sabeshraaj/E-Mesh32/Results/Fig3.jpeg

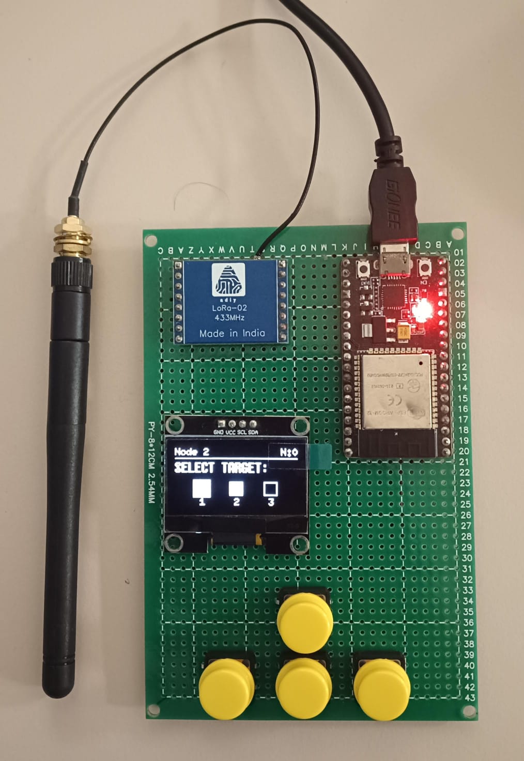
Results/Fig3.jpeg
