sabeshraaj/E-Mesh32/Results/Fig4.jpeg

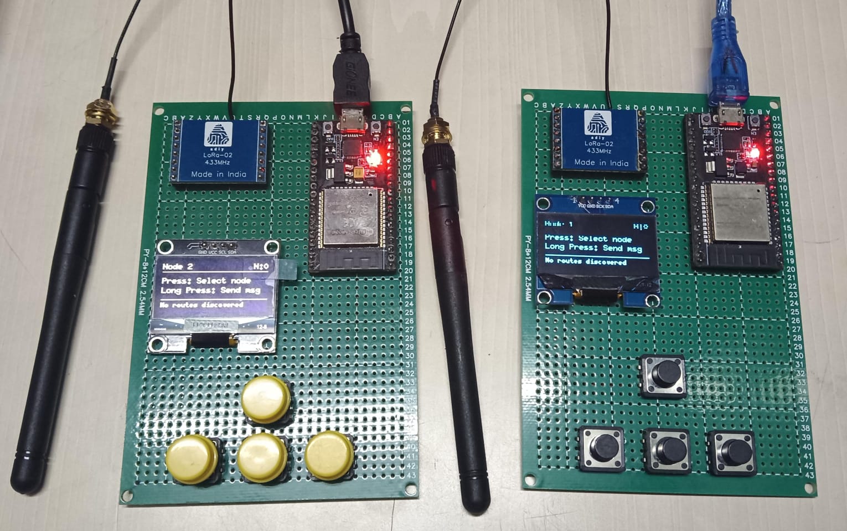
Results/Fig4.jpeg
