sabeshraaj/E-Mesh32/Results/Fig5.jpeg

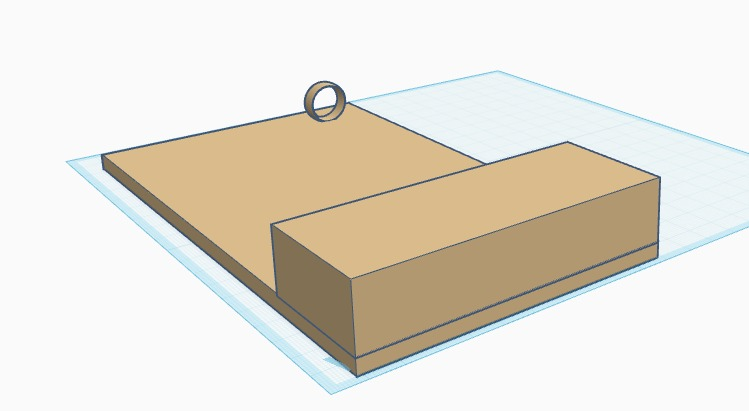
Results/Fig5.jpeg
